zzuzpb/kicad-freakduino/hardware/freakduino-bom.numbers/preview-web.jpg

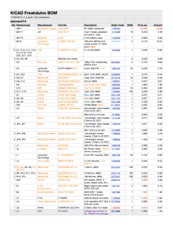
hardware/freakduino-bom.numbers/preview-web.jpg
