zzuzpb/kicad-freakduino/hardware/freakduino-bom.xls

Sheet: element14 - BOM
KiCAD Freakduino BOM
17/08/2013 v1.2 post-r132 corrections
element14
Qty | Reference(s) | Manufacturer | Part No. | Description | Order Code | MOQ | Price ea. | Amount
1 | ANT1 | Amphenol Connex | 132136RP | RP-SMA Connector | 1789593 (http://nz.element14.com/amphenol-connex/dp/1789593) | 1 | 23.660 | 23.66
1 | BATT1 | JST | S2B-XH-A | 2-pin mated, polarized connector, male | 1516289 (http://nz.element14.com/jst/dp/1516289) | 10 | 0.240 | 2.40
1 | BATT2 | Keystone | 2462 | 2-AA battery case | 1702630 (http://nz.element14.com/keystone/dp/1702630) | 1 | 2.660 | 2.66
1 | BLN1 | Johanson Technology | 2450BL14B100E | 100 ohm diff/50 ohm single ended, 2.4 GHz, balun 0805 | 1885503 | 5 | 2.110 | 10.55
10 | C1, C10, C11, C13, C14, C16, C18, C20, C21, C23 | TDK | C1608Y5V1H104Z | 0.1uF/50V,0603 | 1844266 (http://nz.element14.com/tdk/c16085v1h104z/capacitor-ceramic-0-1uf-50v5v-80/dp/1844266) | 1 | 0.030 | 0.30
0 | C2, R3, R9 |  | DNI (Do Not Insert) |  |  | 0 | 0.000 | 0.00
1 | C3 | Nichicon | UWX1C101MCL1GB | 100uF/16V, electrolytic, SMD 6.3mm | 8823065 (http://nz.element14.com/nichicon/dp/8823065) | 5 | 0.120 | 0.60
1 | C4 | Johanson Technology | 251R14S0R4AV4T | 0.4pf, 0603 RF, Hi Q | 1885354 (http://nz.element14.com/johanson-technology/251r14s0r4av4t/capacitor-hi-q-0603-250v-0-4pf/dp/1885354) | 25 | 0.228 | 5.70
2 | C5, C22 | TDK | C2012X5R0J226M/1.25 | 22uF, 6.3V, 0805, MLCC | 2309030 (http://nz.element14.com/tdk/c2012x5r0j226m-1-25/capacitor-22uf-6-3v-x5r-20-0805/dp/2309030) | 1 | 0.214 | 0.43
2 | C6, C7 | Multicomp | MC000291 | 5.6pf, 50V, 0402,RF | 2310316 (http://livepage.apple.com/) | 10 | 0.030 | 0.30
2 | C8, C12 | Multicomp | MC0603B103M250CT | 0.01uF, 0603 | 1709947 (http://nz.element14.com/multicomp/dp/1709947) | 1 | 0.007 | 0.01
1 | C9 | Nichicon | F920G226MPA | 22uf, 6.3V, Tant, 0805 | 1892302 (http://nz.element14.com/nichicon/dp/1892302) | 1 | 1.800 | 1.80
1 | C15 | AVX | 06036D106MAT2A | 10uF, 6.3V, 0603 | 1833804 (http://nz.element14.com/avx/dp/1833804) | 10 | 0.300 | 3.00
2 | C17, C19 | Multicomp | MC0603N120J101CT | 12pF, 50V, 0603 | 1759054 (http://nz.element14.com/multicomp/dp/1759054) | 100 | 0.029 | 2.90
1 | D1 | Vishay | VLMB1300-GS08 | Blue LED, 0603 | 2251459 (http://nz.element14.com/vishay/dp/2251459) | 1 | 0.207 | 0.21
2 | D2, D6 | Vishay | VLMO1300-GS08 | Red LED, 0603 | 2251473 (http://nz.element14.com/vishay/vlmo1300-gs08/led-0603-red/dp/2251473) | 1 | 0.207 | 0.41
2 | D3, D4 | Vishay | VLMTG1300-GS08 | Green LED, 0603 | 2251490 (http://nz.element14.com/vishay/dp/2251490) | 1 | 0.160 | 0.32
1 | FB1 | Fair-Rite | 2508051027Y0 | Ferrite Bead, 0805 | 2112874 (http://nz.element14.com/fair-rite/dp/2112874) | 1 | 0.022 | 0.02
1 | H3 | Molex | 10897061 (see below) | 3x2 straight male header, 2.54mm (0.100”) | 1508365 (http://nz.element14.com/molex/10897061/board-board-connector-header-6way/dp/1508365) | 1 | 0.902 | 0.90
 |  |  | -----> | 30x2 and cut to size | 1918095 (http://nz.element14.com/fci/dp/1918095) | 1 | 2.630 | 2.63
1 | JP1 | Molex | 22-28-5030 (see below) | 1x3 straight male header, 2.54mm (0.100”) | 1513726 (http://nz.element14.com/molex/22-28-5030/header-3way/dp/1513726) | 1 | 0.077 | 0.08
2 | JP2, JP7 | Molex | 22-28-4022 (see below) | 1x2 straight male header, 2.54mm (0.100”) | 1704910 (http://nz.element14.com/molex/22-28-4022/board-board-connector-header-2way/dp/1704910) | 1 | 0.201 | 0.40
 |  |  | -----> | 30x1 and cut to size | 1819800 (http://nz.element14.com/te-connectivity-amp/dp/1819800) | 1 | 4.060 | 4.06
2 | JP4, JP6 | Global Connector | BG095-08-A-N-D | 1x8 straight female header, 2.54mm (0.100”) | 1799005 (http://nz.element14.com/global-connector-technology/dp/1799005) | 1 | 1.890 | 3.78
2 | JP3, JP5 | Global Connector | BG095-06-A-N-D | 1x6 straight female header, 2.54mm (0.100”) | 1799003 (http://nz.element14.com/global-connector-technology/dp/1799003) | 1 | 1.420 | 2.84
1 | J1 | Multicomp | MC32598 | USB Mini-AB connector | 1696539 (http://nz.element14.com/multicomp/mc32598/mini-usb-type-ab-receptacle-smt/dp/1696539) | 1 | 2.280 | 2.28
1 | J2 | Lumberg | NEB 21 R | DC Power Jack, 1.95mm center conductor | 1217037 (http://nz.element14.com/lumberg/dp/1217037) | 1 | 2.260 | 2.26
1 | L1 | Johanson Technology | L-14C3N3SV4T | 3.3nH RF inductor, 0603 | 1865790 (http://nz.element14.com/johanson-technology/dp/1865790) | 50 | 0.132 | 6.60
1 | L2 | Taiyo Yuden | NR4018T4R7M | 4.7uH inductor, 1.2A, 4x4mm | 1284636 (http://nz.element14.com/taiyo-yuden/dp/1284636) | 1 | 0.550 | 0.55
7 | R1, R2, R4, R5, R7, R8, R12 | Multicomp | MCMR06X102 JTL | 1 Kohm, 0603 | 2073354 (http://nz.element14.com/multicomp/mcmr06x102-jtl/resistor-anti-sulfur-1k-0603-5/dp/2073354) | 100 | 0.005 | 0.50
4 | R6, R10, R11, R13 | Multicomp | MCSR06X103 JTL | 10 Kohms, 0603 | 2074170 (http://nz.element14.com/multicomp/mcsr06x103-jtl/resistor-anti-sulfur-10k-0603-5/dp/2074170) | 100 | 0.003 | 0.30
2 | R14, R15 | Multicomp | MCMR06X104 JTL | 100 Kohms, 0603 | 2073357 (http://nz.element14.com/multicomp/mcmr06x104-jtl/resistor-anti-sulfur-100k-0603/dp/2073357) | 100 | 0.003 | 0.30
1 | SW1 | Omron | A6TN-2104 | DIP switch, SPST, 2 poles, raised slide, thru | 2066443 (http://nz.element14.com/omron-electronic-components/a6tn-2104/dip-switch-2-spst-raised-slide/dp/2066443) | 1 | 2.660 | 2.66
1 | S1 | C & K Components | OS102011MA1QN1 | Right angle slide switch, SPDT, ON-ON | 1201431 (http://nz.element14.com/c-k-components/os102011ma1qn1/switch-spdt-0-1a-12v-pcb-r-a/dp/1201431) | 5 | 1.820 | 9.10
1 | S2 | Wurth Elektronik | 430471031826 | SMD SPST Tactile Switch/Pushbutton | 1867986 (http://nz.element14.com/wurth-elektronik/430471031826/switch-260gf-washable-blk-smd-3/dp/1867986) | 1 | 1.360 | 1.36
1 | U1 | FTDI | FT232RL | USB-to-Serial converter | 1146032 (http://nz.element14.com/ftdi/ft232rl/ic-usb-to-uart-smd-28ssop/dp/1146032) | 1 | 11.830 | 11.83
1 | U2 | Texas Instruments | LM3940IMP-3.3 | 3.3V regulator SOT-223-3 (IGO pin order) | 9779280 (http://nz.element14.com/texas-instruments/dp/9779280) | 1 | 2.280 | 2.28
1 | U3 | Atmel | AT86RF231-ZU QFN | 2.4GHz, 802.15.4 radio. | 1748493 (http://nz.element14.com/atmel/at86rf231-zu/transceiver-zigbee-802-15-4-4-32qfn/dp/1748493) | 1 | 8.970 | 8.97
1 | U4 | NXP | GTL2003 | Voltage level shifter, 8-bit, TSSOP-20 package | 2212068 (http://nz.element14.com/nxp/gtl2003pw/ic-gtl-lo-volt-translator-20tssop/dp/2212068) | 1 | 1.260 | 1.26
1 | U5 | Texas Instruments | TPS61222DCKT | 5V boost converter | 1755643 (http://livepage.apple.com/) | 1 | 2.930 | 2.93
1 | U6 | Atmel | ATMEGA328-AU | AVR Microcontroller QFP32 | 1972086 (http://nz.element14.com/atmel/atmega328-au/mcu-8bit-avr-32k-flash-32tqfp/dp/1972086) | 1 | 4.450 | 4.45
1 | VR1 | ST Micro | L78M05CDT-TR | 5.0V regulator D-PAK 500mA | 1261392 (http://nz.element14.com/stmicroelectronics/l78m05cdt-tr/ic-linear-voltage-regulator-5v/dp/1261392) | 1 | 0.890 | 0.89
1 | Y1 | Aker | C3E-16.000-12-1010-X | 16MHz crystal, 10ppm, 12pf | 1640978 (http://nz.element14.com/aker/c3e-16-000-12-1010-x/crystal-2-5x3mm-cer-16-000mhz/dp/1640978) | 1 | 6.210 | 6.21
 |  |  |  |  |  |  | Total | 134.70
COLOUR KEY
 | BLACK | As originally specified for Freakduino v2.1a.
 | ORANGE | Alternative part with same footprint as original. Additional orange text shows difference in part parameters.
 | PURPLE | Alternative part with different footprint to original.
 | RED | Part not available and no alternative so far found. Red in price column indicates price unreasonably high.

Sheet: digikey - BOM
KiCAD Freakduino BOM
DigiKey
Qty | Reference(s) | Manufacturer | Part No. | Description | DigiKey SKU | MOQ | USD ea. | Amount
1 | ANT1 | ChangHong | SMA-02-113-TGG | RP-SMA Connector |  |  | 0.00
1 | BATT1 | JST | JST-XH2P | 2-pin mated, polarized connector, male
1 | BATT2 | COMF | BH321-1P | 2-AA battery case
1 | BLN1 | Murata | LDB-182G4510C-110 | 100 ohm diff/50 ohm single ended, 2.4GHz, balun
10 | C1,C10,C11,C13,C14,C16,C18,C20,C21,C23 | Various |  | 0.1uF/50V,0603
0 | C2,R3,R9 |  | DNI
1 | C3 | Various |  | 100uF/16V
1 | C4 | Johanson Technology | 251R14S0R4 | 0.4pf,0603 RF capacitor
2 | C5,C22 | Various |  | 22uF, 6.3V,0805, MLCC
2 | C6,C7 | Taiyo Yuden | UMK105C-G5R6DW-F | 5.6pf,50V,0402,RF
2 | C8,C12 | Various |  | 0.01uF, 0603
2 | C9,C15 | Various |  | 100uF, 35V, thru
2 | C17,C19 | Various |  | 12pF, 50V, 0603
1 | D1 | Various |  | Blue LED, 0603
2 | D2,D6 | Various |  | Red LED, 0603
2 | D3,D4 | Various |  | Green LED, 0603
1 | D5 | Vishay | BAT43 | Schottky Diode, thru
1 | FB1 | Various |  | Ferrite Bead, 0805
1 | H3 | Various | H3X2 | 3x2 straight male header, 2.54mm (0.100”)
1 | JP1 | Various | JP3/THRU_VERT | 1x3 straight male header, 2.54mm (0.100”)
2 | JP2,JP7 | Various | 1X2 | 1x2 straight male header, 2.54mm (0.100”)
2 | JP4,JP6 | Various |  | 1x8 straight male header, 2.54mm (0.100”)
2 | JP3,JP5 | Various |  | 1x6 straight male header, 2.54mm (0.100”)
1 | J1 | 4UCON | 9558 | USB Mini-AB connector
1 | J2 | 4UCON | 5537 | DC Power Jack, 2.0mm center conductor
1 | L1 | Johanson Technology | L-14C3N3SV4T | 3.3nH RF inductor
1 | L2 | Various |  | 47uH inductor, 200mA, thru
5 | R1,R2,R7,R8,R12 | Various |  | 220 ohms, 0603
4 | R6,R10,R11,R13 |  |  | 10 Kohms, 0603
2 | R14,R15 | Various |  | 100 Kohms, 0603
2 | R4,R5 | Various |  | 1 Kohm, 0603
1 | SW1 | Various |  | 2-input DIP switch, thru
1 | S1 | Various |  | Right angle slide switch
1 | S2 | Various |  | SMD SPST Tactile Switch/Pushbutton
1 | U1 | FTDI | FT232RL | USB-to-Serial converter
1 | U2 | Microchip | TC1264-3.3 | 3.3V regulator
1 | U3 | Atmel | AT86RF231 | 2.4GHz, 802.15.4 radio
1 | U4 | Fairchild | FXMA108 | Voltage level converter, DQFN-20 package | FXMA108BQXFSCT-ND (http://www.digikey.com/product-detail/en/FXMA108BQX/FXMA108BQXFSCT-ND/2287325) | 1 | 1.52
1 | U5 | Holtek | HT7750A | 5V boost converter | NOT AVAILABLE
1 | U6 | Atmel | ATMEGA328-QFP32 | AVR Microcontroller
1 | VR1 | NJRC | NJM2845-5.0 | 5.0V regulator
1 | Y1 | NDK | NX3225SA,15ppm | 16MHz crystal, 15ppm
