zzuzpb/kicad-freakduino/hardware/parts-layout/parts-layout_v1.2.png

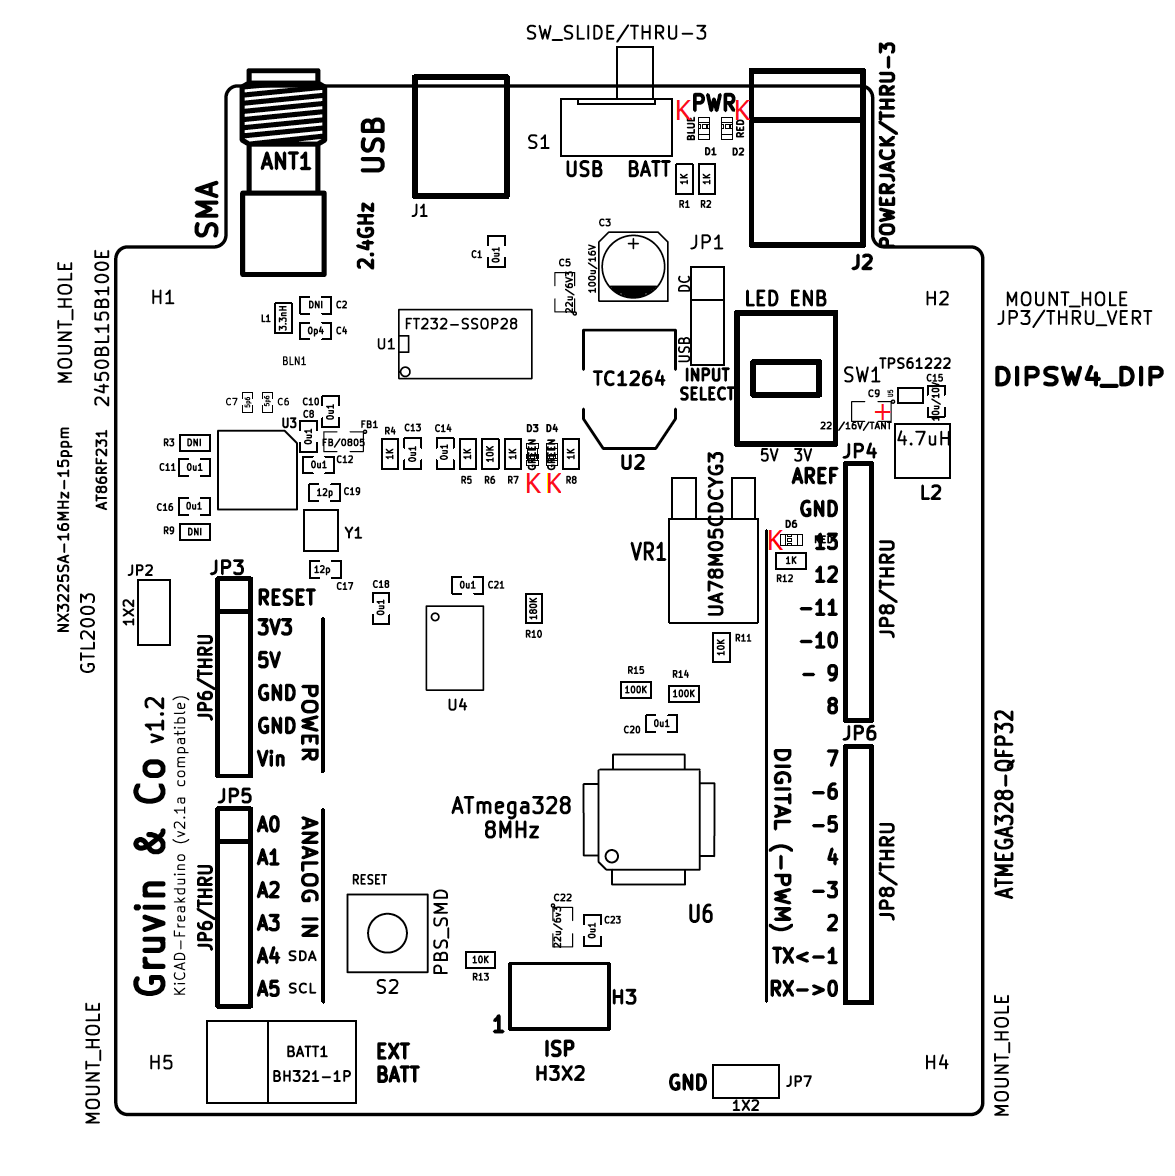
hardware/parts-layout/parts-layout_v1.2.png
