zzuzpb/kicad-freakduino/hardware/radio-only-bom.numbers/preview-web.jpg

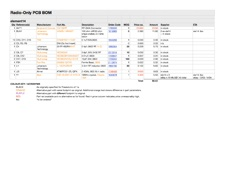
hardware/radio-only-bom.numbers/preview-web.jpg
