zzuzpb/kicad-freakduino/hardware/parts-layout/parts-layout_v1.2.pdf

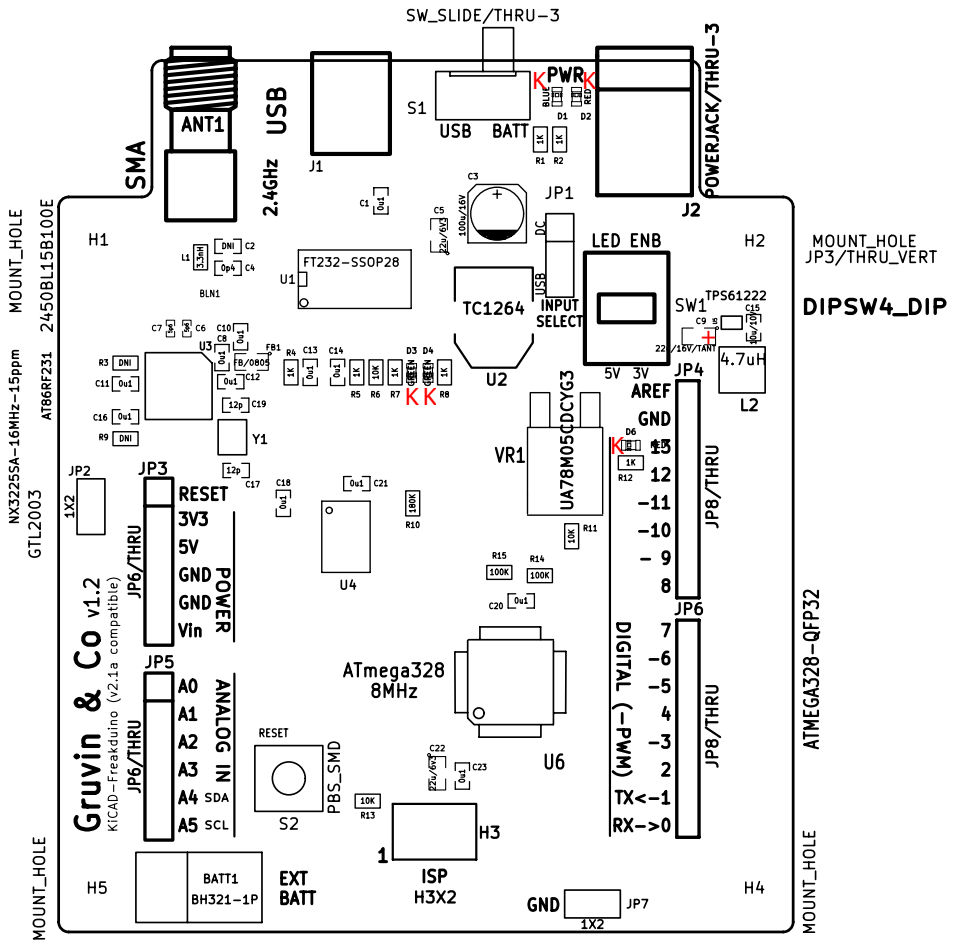
[picture p4: page 1]
