zzuzpb/kicad-freakduino/hardware/freakduino-alt.sch

## KiCad design hardware/freakduino-alt.sch (2014-03-27)

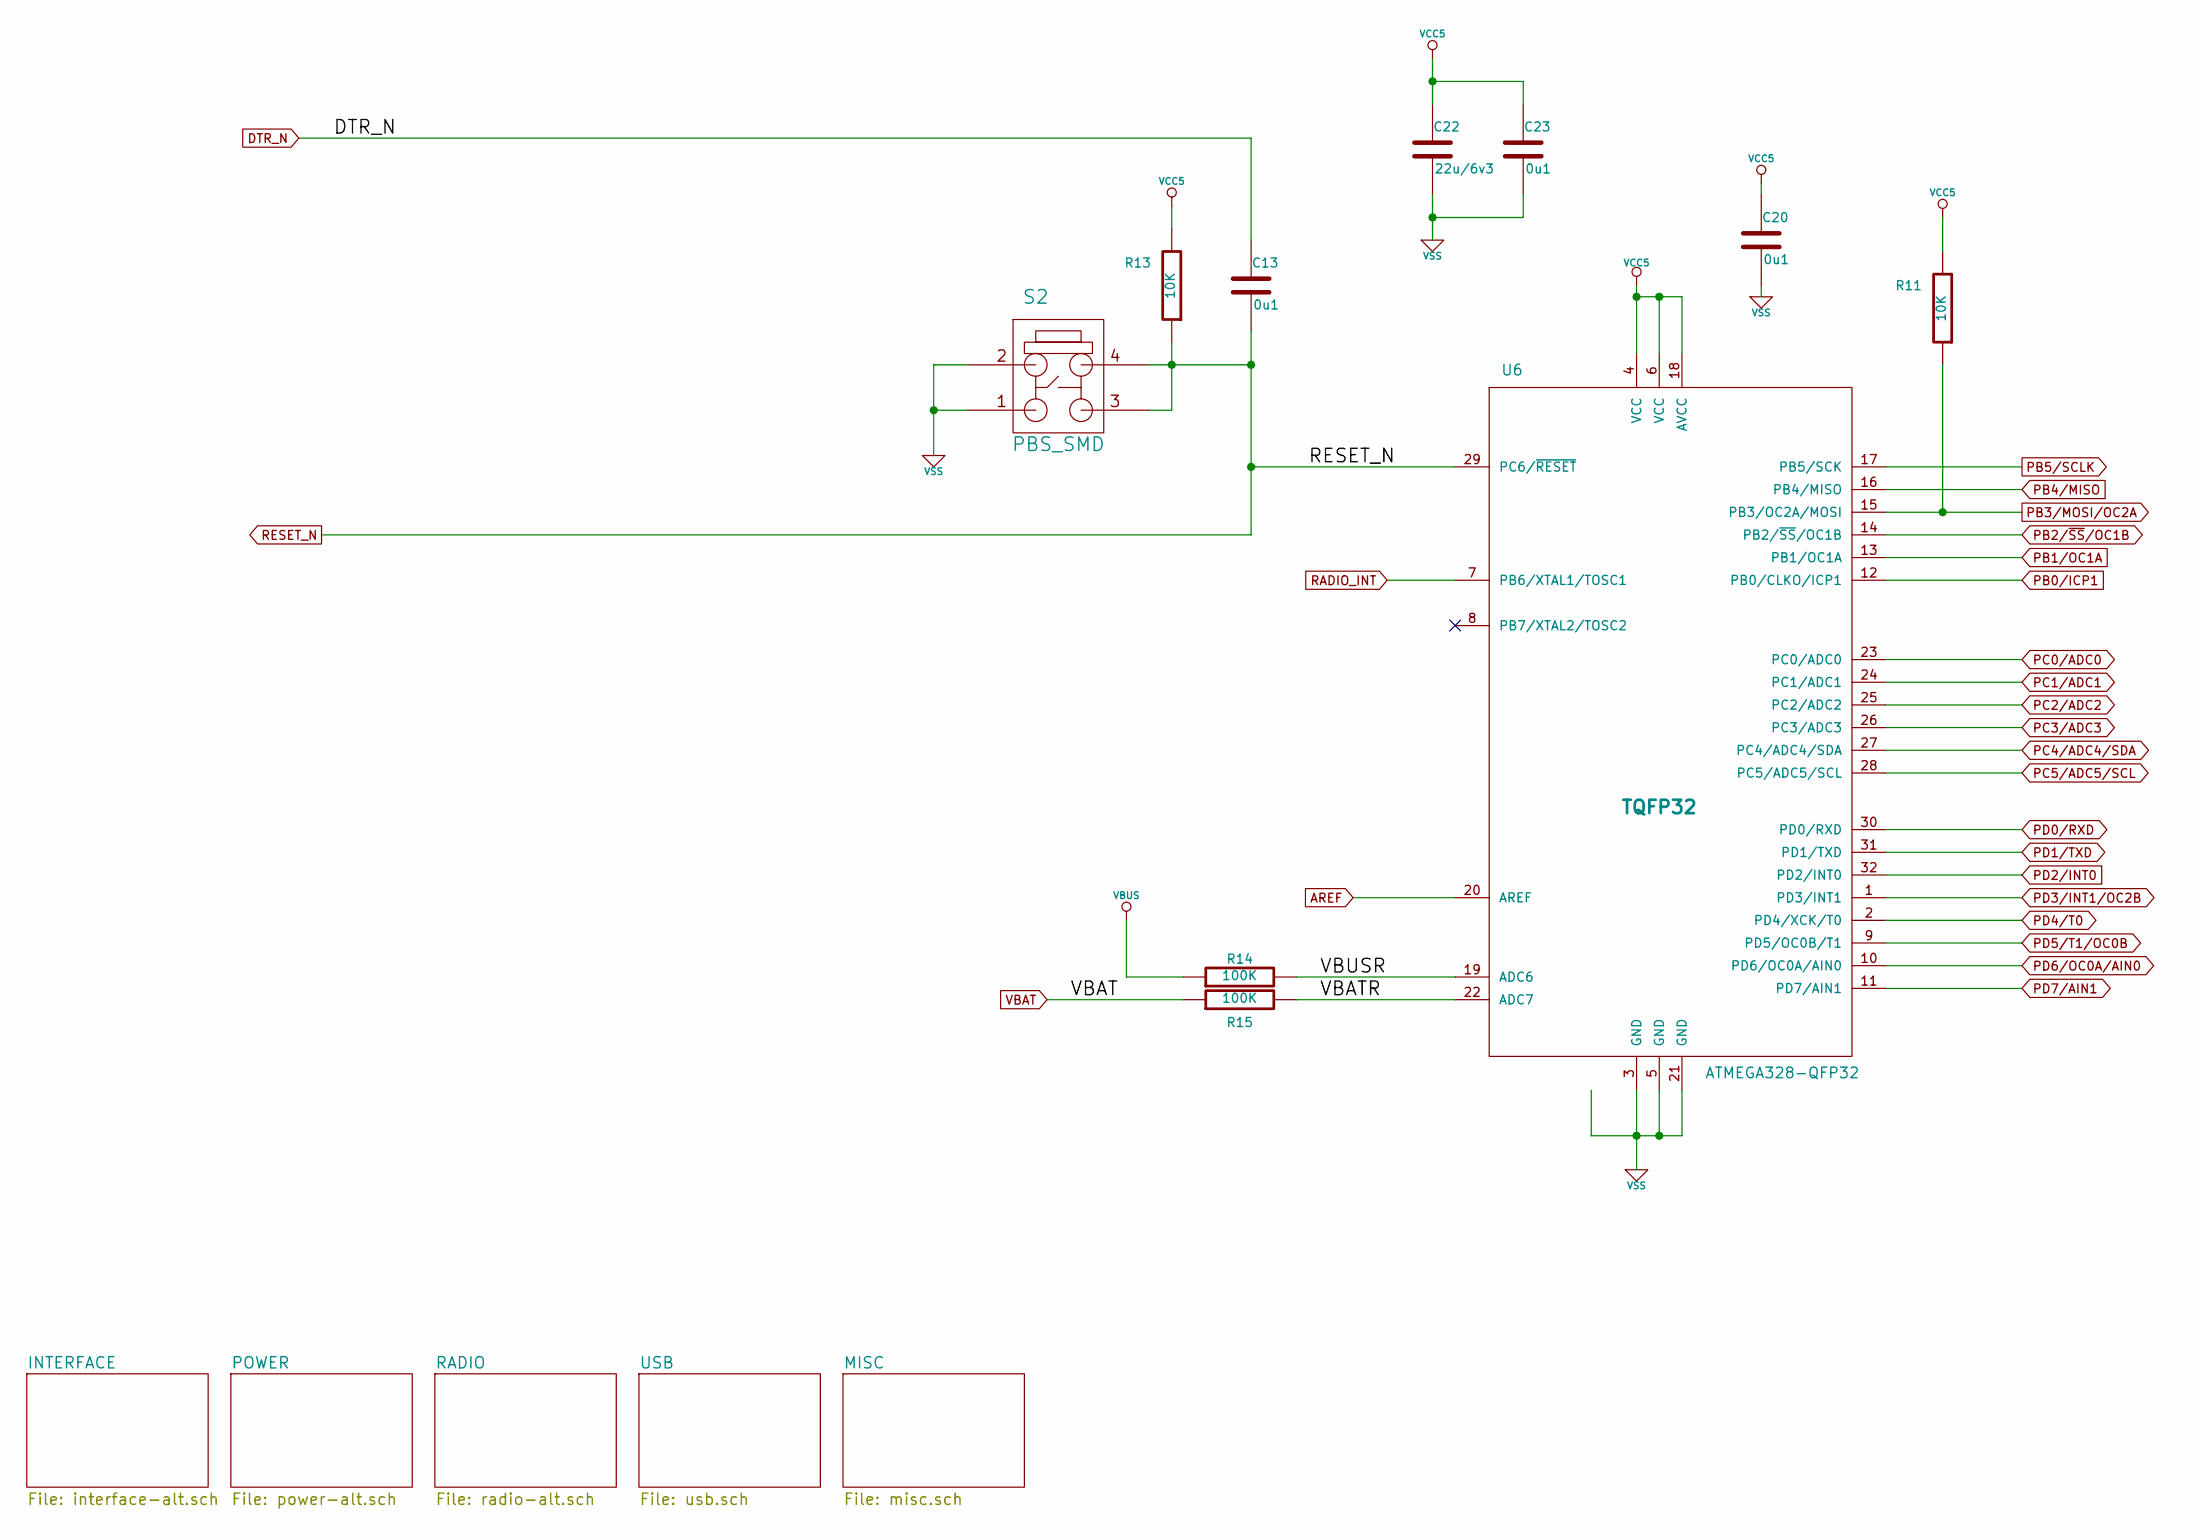
[picture p5: schematic freakduino-alt.sch]

Parts:
C13, C20, C23: 0u1
C22: 22u/6v3
R11, R13: 10K
R14, R15: 100K
S2: PBS_SMD
U6: ATMEGA328-QFP32; TQFP32

Connections:
AREF: U6.20 (AREF)
DTR_N: C13.1
PB0/ICP1: U6.12 (PB0/CLKO/ICP1)
PB1/OC1A: U6.13 (PB1/OC1A)
PB2/~SS~/OC1B: U6.14 (PB2/~SS~/OC1B)
PB3/MOSI/OC2A: R11.1, U6.15 (PB3/OC2A/MOSI)
PB4/MISO: U6.16 (PB4/MISO)
PB5/SCLK: U6.17 (PB5/SCK)
PC0/ADC0: U6.23 (PC0/ADC0)
PC1/ADC1: U6.24 (PC1/ADC1)
PC2/ADC2: U6.25 (PC2/ADC2)
PC3/ADC3: U6.26 (PC3/ADC3)
PC4/ADC4/SDA: U6.27 (PC4/ADC4/SDA)
PC5/ADC5/SCL: U6.28 (PC5/ADC5/SCL)
PD0/RXD: U6.30 (PD0/RXD)
PD1/TXD: U6.31 (PD1/TXD)
PD2/INT0: U6.32 (PD2/INT0)
PD3/INT1/OC2B: U6.1 (PD3/INT1)
PD4/T0: U6.2 (PD4/XCK/T0)
PD5/T1/OC0B: U6.9 (PD5/OC0B/T1)
PD6/OC0A/AIN0: U6.10 (PD6/OC0A/AIN0)
PD7/AIN1: U6.11 (PD7/AIN1)
RADIO_INT: U6.7 (PB6/XTAL1/TOSC1)
RESET_N: C13.2, R13.1, S2.3, S2.4, U6.29 (PC6/~RESET)
VBAT: R15.1
VBATR: R15.2, U6.22 (ADC7)
VBUS: R14.1
VBUSR: R14.2, U6.19 (ADC6)
VCC5: C20.1, C22.1, C23.1, R11.2, R13.2, U6.4 (VCC), U6.6 (VCC), U6.18 (AVCC)
VSS: C20.2, C22.2, C23.2, S2.1, S2.2, U6.3 (GND), U6.5 (GND), U6.21 (GND)
