zzuzpb/kicad-freakduino/hardware/interface.sch

## KiCad design hardware/interface.sch (2014-03-03)

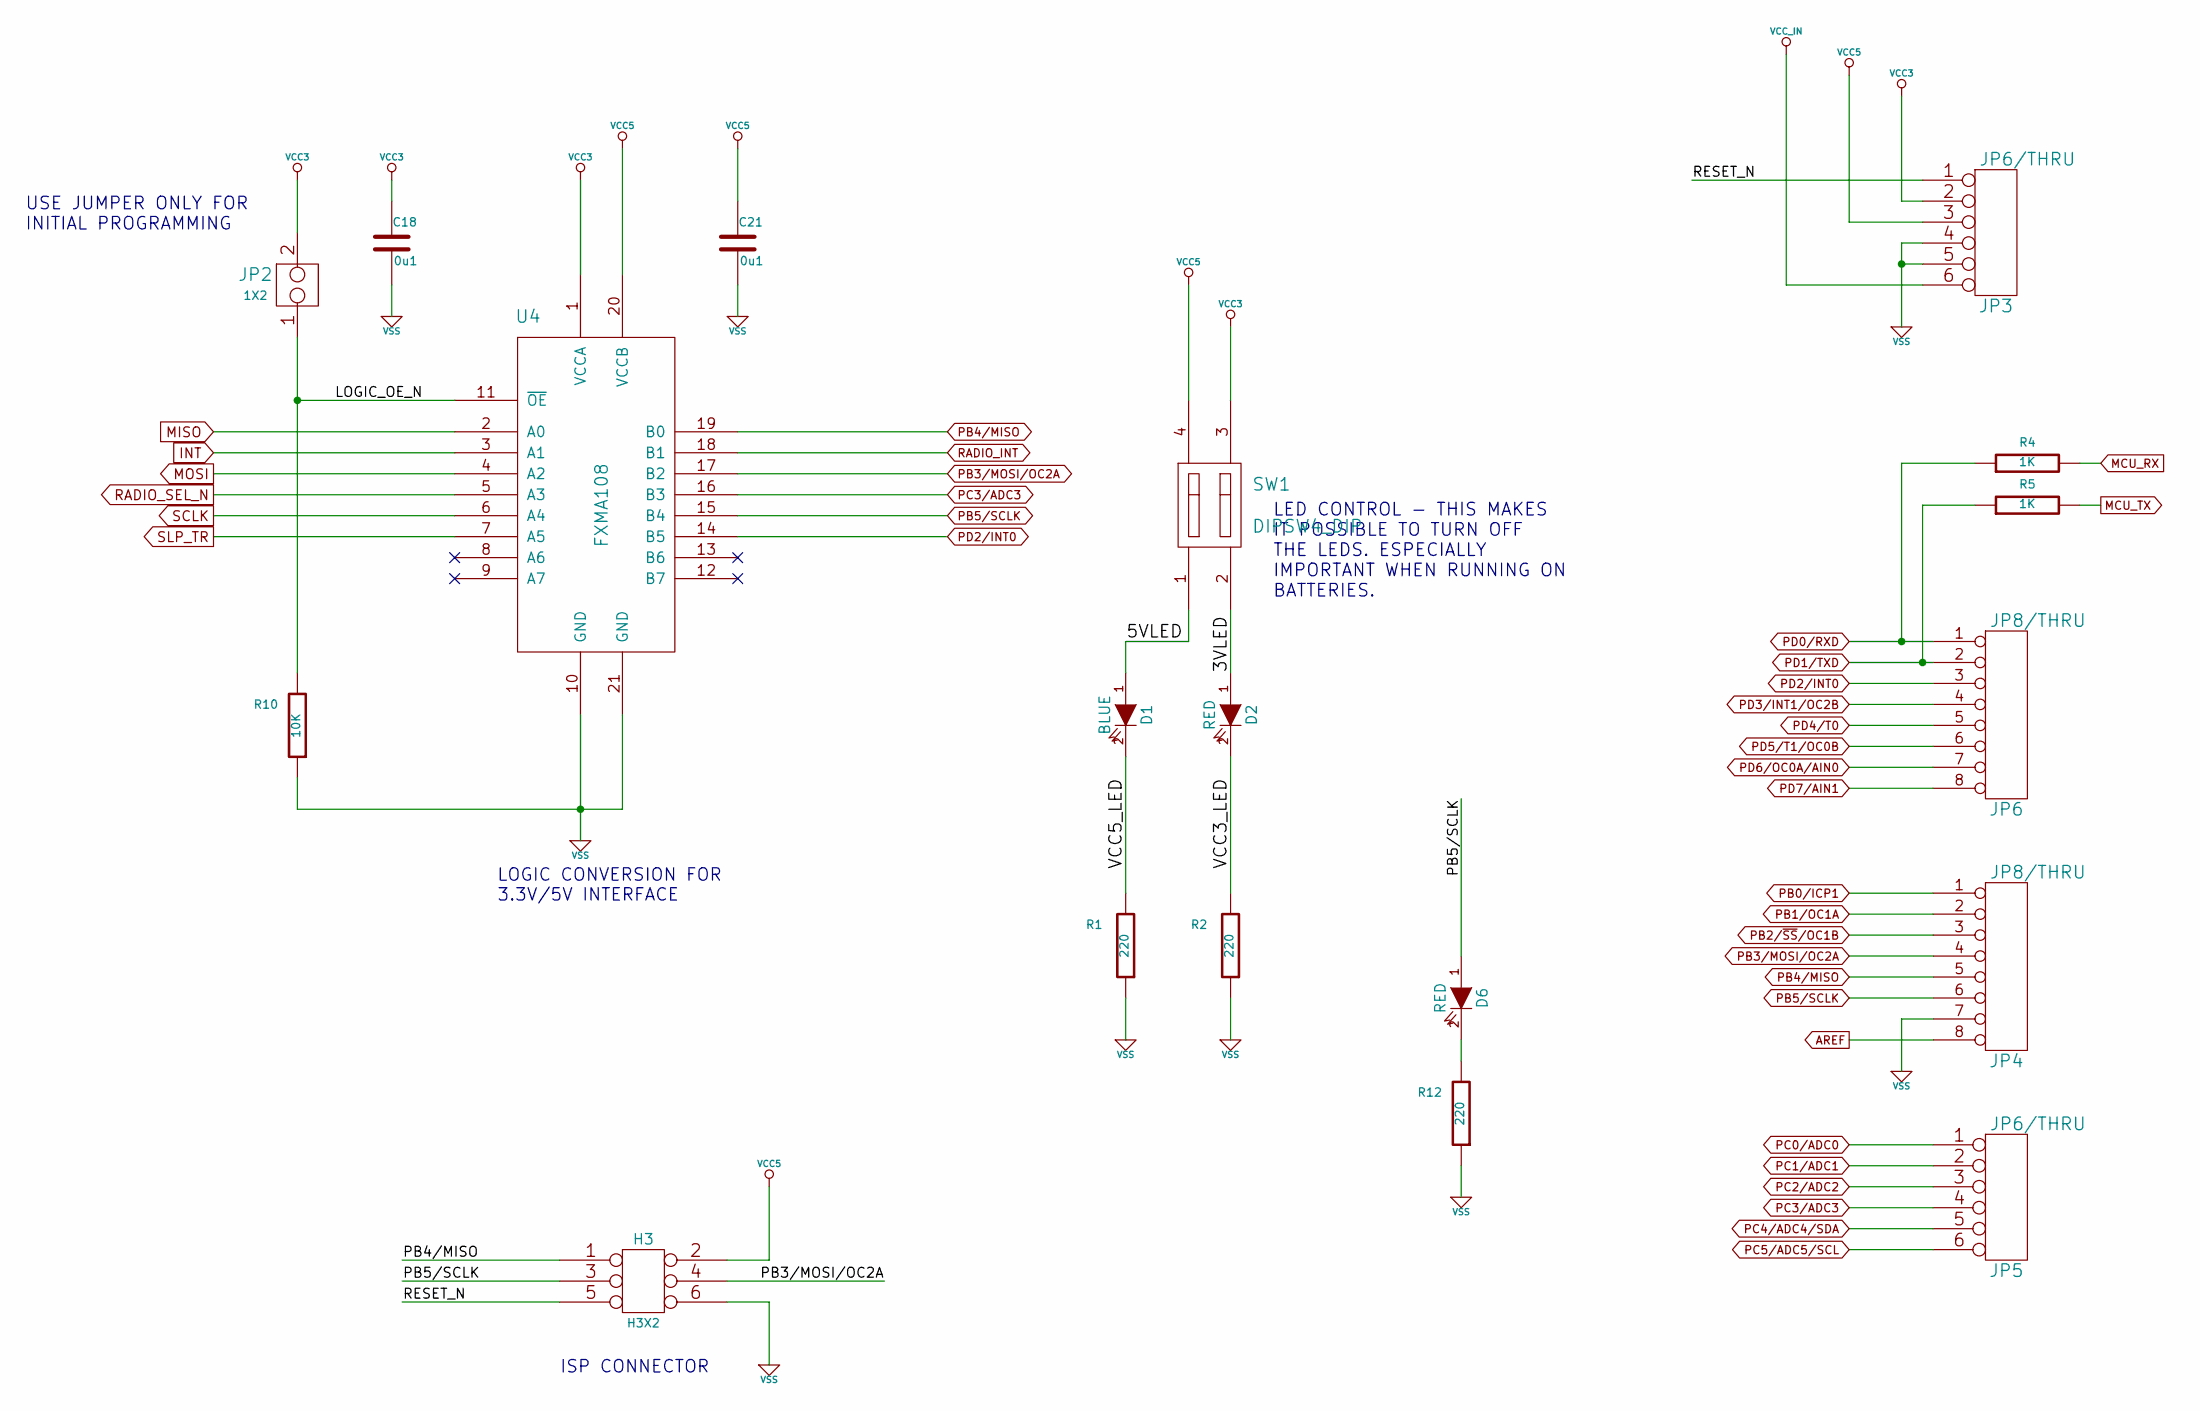
[picture p7: schematic interface.sch]

Parts:
C18, C21: 0u1
D1: BLUE
D2, D6: RED
H3: H3X2
JP2: 1X2
JP3, JP5: JP6/THRU
JP4, JP6: JP8/THRU
R1, R2, R12: 220
R4, R5: 1K
R10: 10K
SW1: DIPSW4_DIP
U4: FXMA108

Connections:
3VLED: D2.1 (A), SW1.2
5VLED: D1.1 (A), SW1.1
AREF: JP4.8
INT: U4.3 (A1)
LOGIC_OE_N: JP2.1, R10.2, U4.11 (~OE)
MCU_RX: R4.2
MCU_TX: R5.2
MISO: U4.2 (A0)
MOSI: U4.4 (A2)
unnamed: D6.2 (K), R12.2
PB0/ICP1: JP4.1
PB1/OC1A: JP4.2
PB2/~SS~/OC1B: JP4.3
PB3/MOSI/OC2A: H3.4, JP4.4, U4.17 (B2)
PB4/MISO: H3.1, JP4.5, U4.19 (B0)
PB5/SCLK: D6.1 (A), H3.3, JP4.6, U4.15 (B4)
PC0/ADC0: JP5.1
PC1/ADC1: JP5.2
PC2/ADC2: JP5.3
PC3/ADC3: JP5.4, U4.16 (B3)
PC4/ADC4/SDA: JP5.5
PC5/ADC5/SCL: JP5.6
PD0/RXD: JP6.1, R4.1
PD1/TXD: JP6.2, R5.1
PD2/INT0: JP6.3, U4.14 (B5)
PD3/INT1/OC2B: JP6.4
PD4/T0: JP6.5
PD5/T1/OC0B: JP6.6
PD6/OC0A/AIN0: JP6.7
PD7/AIN1: JP6.8
RADIO_INT: U4.18 (B1)
RADIO_SEL_N: U4.5 (A3)
RESET_N: H3.5, JP3.1
SCLK: U4.6 (A4)
SLP_TR: U4.7 (A5)
VCC3: C18.1, JP2.2, JP3.2, SW1.3, U4.1 (VCCA)
VCC3_LED: D2.2 (K), R2.2
VCC5: C21.1, H3.2, JP3.3, SW1.4, U4.20 (VCCB)
VCC5_LED: D1.2 (K), R1.2
VCC_IN: JP3.6
VSS: C18.2, C21.2, H3.6, JP3.4, JP3.5, JP4.7, R1.1, R2.1, R10.1, R12.1, U4.10 (GND), U4.21 (GND)

Notes on the sheet:
LOGIC CONVERSION FOR 3.3V/5V INTERFACE
USE JUMPER ONLY FOR INITIAL PROGRAMMING
LED CONTROL - THIS MAKES IT POSSIBLE TO TURN OFF THE LEDS. ESPECIALLY IMPORTANT WHEN RUNNING ON BATTERIES.
ISP CONNECTOR
