zzuzpb/kicad-freakduino/hardware/misc.sch

## KiCad design hardware/misc.sch (2014-03-27)

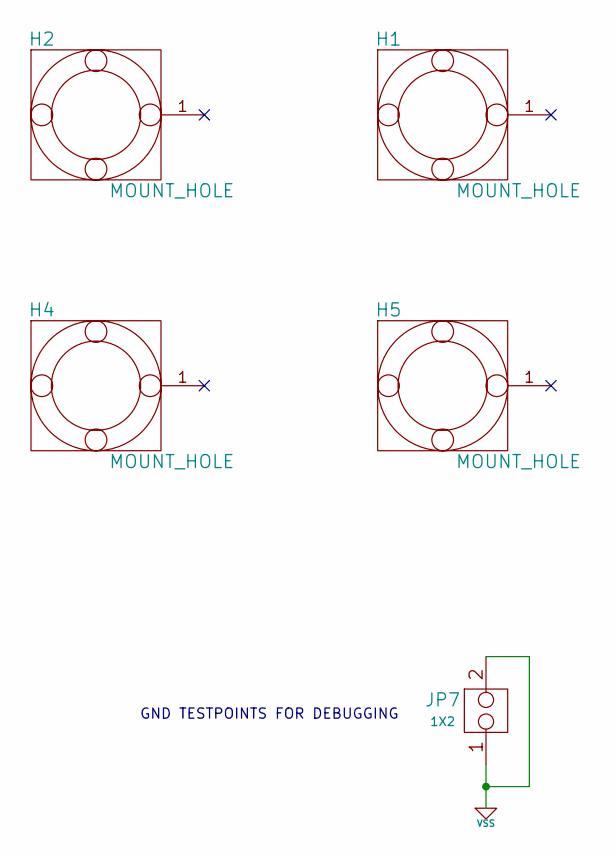
[picture p8: schematic misc.sch]

Parts:
H1, H2, H4, H5: MOUNT_HOLE
JP7: 1X2

Connections:
VSS: JP7.1, JP7.2

Notes on the sheet:
GND TESTPOINTS FOR DEBUGGING
