zzuzpb/kicad-freakduino/hardware/power-alt.sch

## KiCad design hardware/power-alt.sch (2014-03-03)

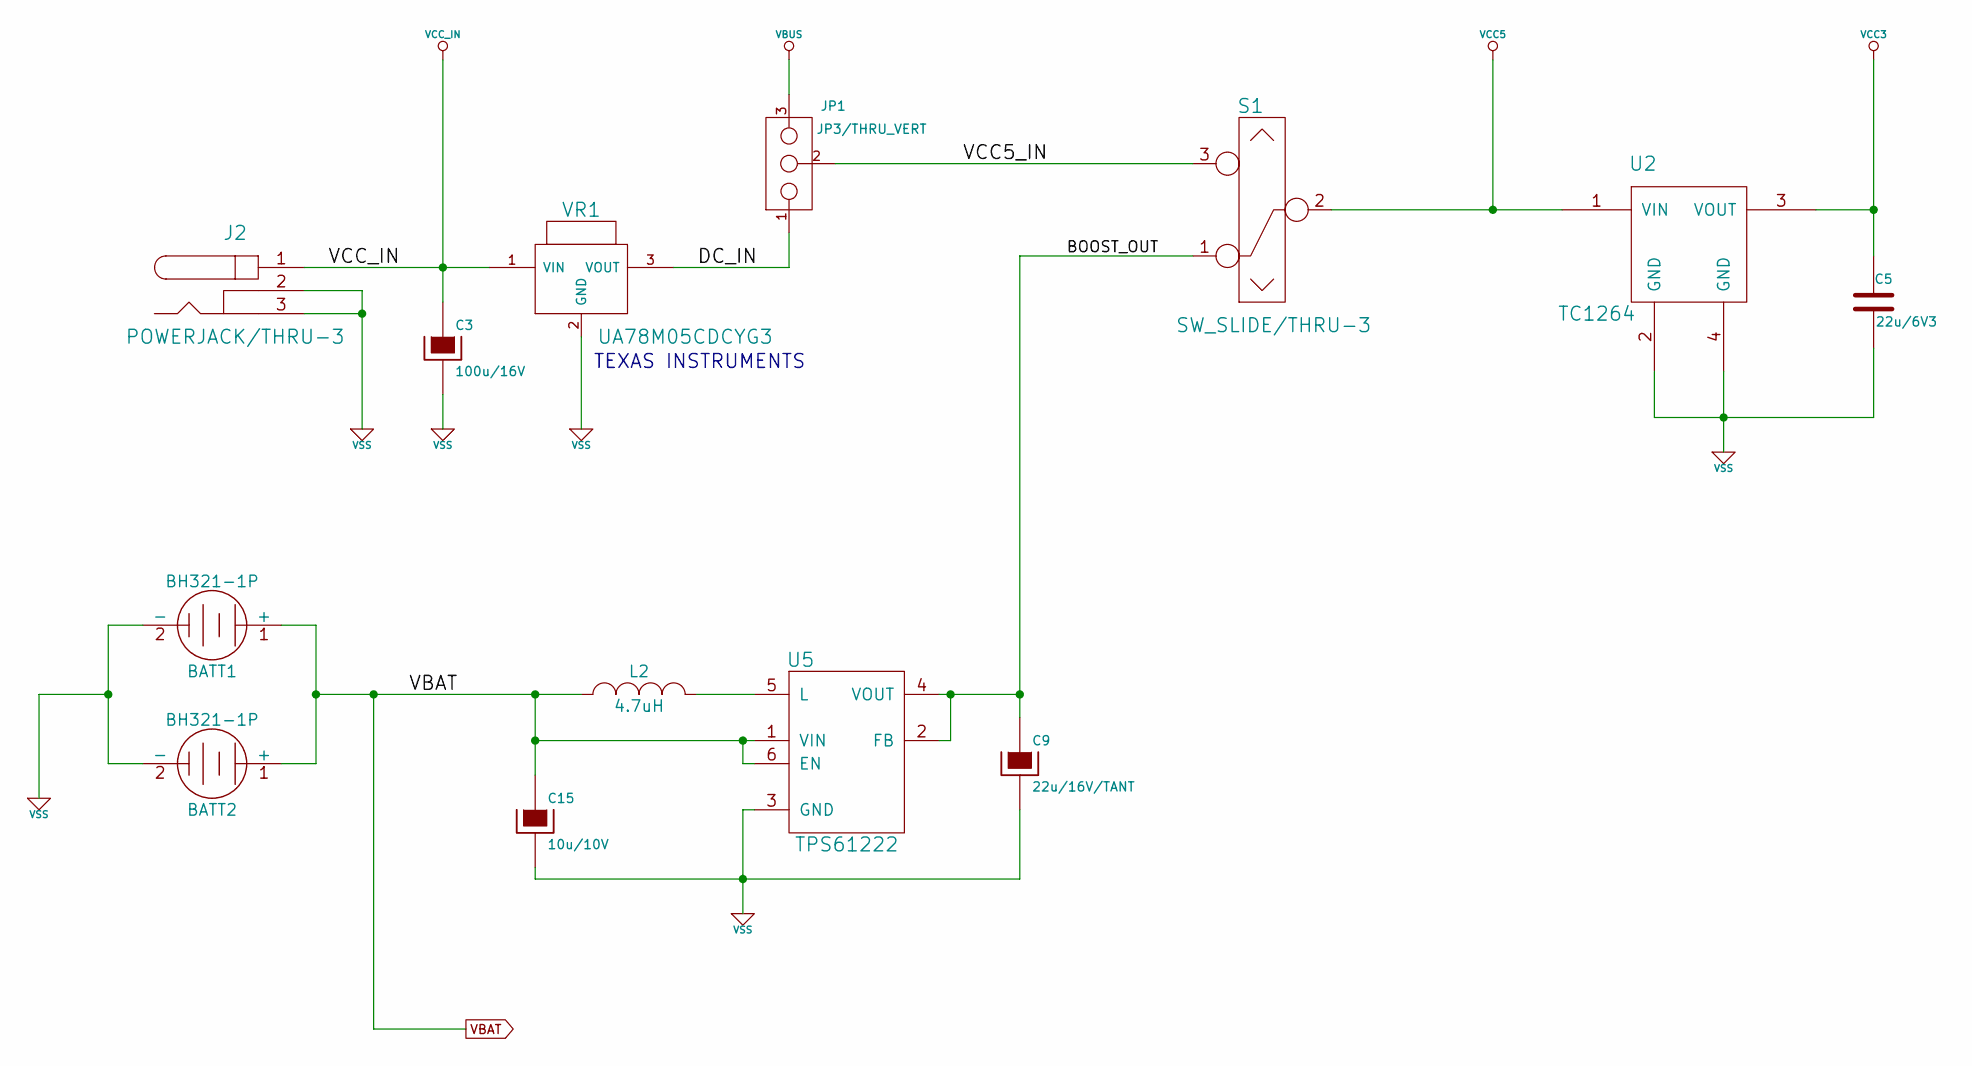
[picture p9: schematic power-alt.sch]

Parts:
BATT1, BATT2: BH321-1P
C3: 100u/16V
C5: 22u/6V3
C9: 22u/16V/TANT
C15: 10u/10V
J2: POWERJACK/THRU-3
JP1: JP3/THRU_VERT
L2: 4.7uH
S1: SW_SLIDE/THRU-3
U2: TC1264
U5: TPS61222
VR1: UA78M05CDCYG3

Connections:
BOOST_OUT: C9.1, S1.1, U5.2 (FB), U5.4 (VOUT)
DC_IN: JP1.1, VR1.3 (VOUT)
unnamed: L2.2, U5.5 (L)
VBAT: BATT1.1 (+), BATT2.1 (+), C15.1, L2.1, U5.1 (VIN), U5.6 (EN)
VBUS: JP1.3
VCC3: C5.1, U2.3 (VOUT)
VCC5: S1.2, U2.1 (VIN)
VCC5_IN: JP1.2, S1.3
VCC_IN: C3.1, J2.1, VR1.1 (VIN)
VSS: BATT1.2 (-), BATT2.2 (-), C3.2, C5.2, C9.2, C15.2, J2.2, J2.3, U2.2 (GND), U2.4 (GND), U5.3 (GND), VR1.2 (GND)

Notes on the sheet:
TEXAS INSTRUMENTS
