zzuzpb/kicad-freakduino/hardware/power.sch

## KiCad design hardware/power.sch (2014-03-03)

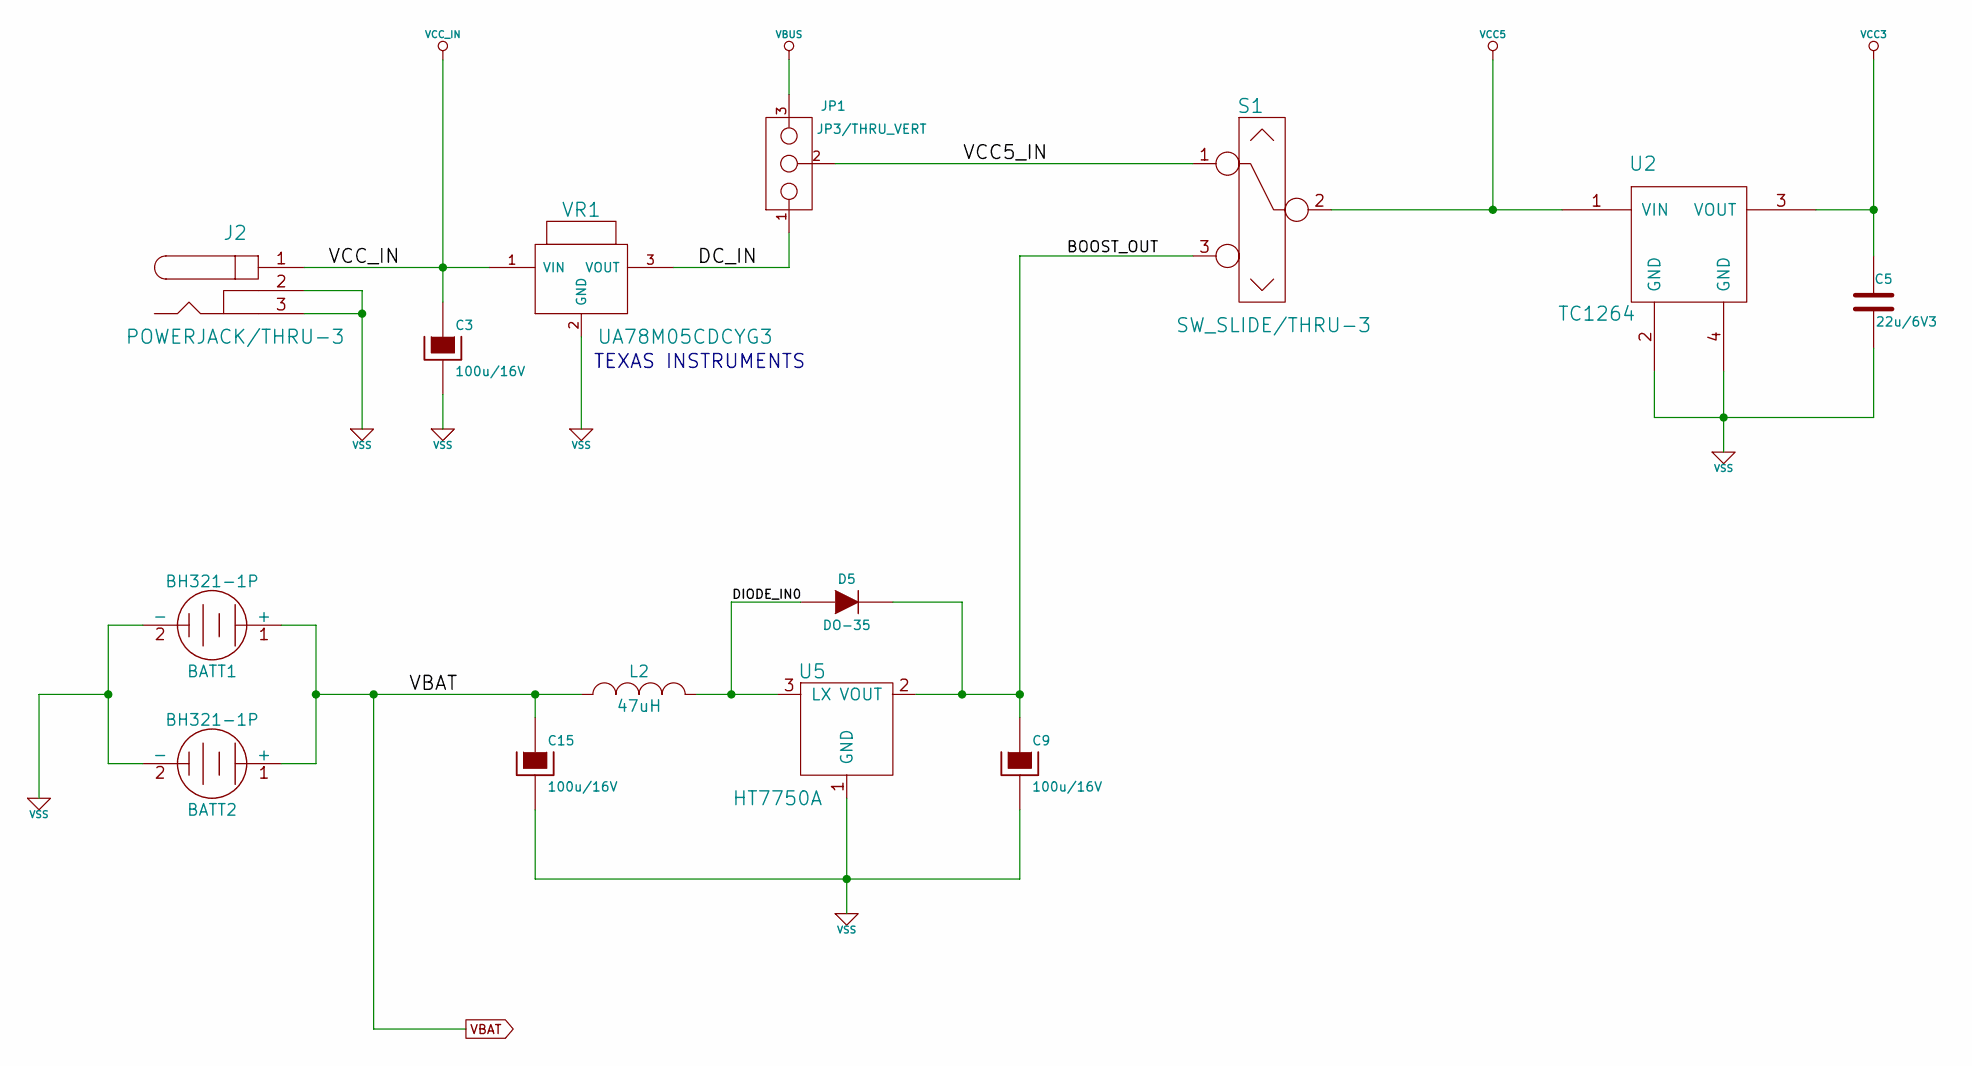
[picture p10: schematic power.sch]

Parts:
BATT1, BATT2: BH321-1P
C3, C9, C15: 100u/16V
C5: 22u/6V3
D5: DO-35; Part No BAT43
J2: POWERJACK/THRU-3
JP1: JP3/THRU_VERT
L2: 47uH
S1: SW_SLIDE/THRU-3
U2: TC1264
U5: HT7750A
VR1: UA78M05CDCYG3

Connections:
BOOST_OUT: C9.1, D5.2 (K), S1.3, U5.2 (VOUT)
DC_IN: JP1.1, VR1.3 (VOUT)
DIODE_IN0: D5.1 (A), L2.2, U5.3 (LX)
VBAT: BATT1.1 (+), BATT2.1 (+), C15.1, L2.1
VBUS: JP1.3
VCC3: C5.1, U2.3 (VOUT)
VCC5: S1.2, U2.1 (VIN)
VCC5_IN: JP1.2, S1.1
VCC_IN: C3.1, J2.1, VR1.1 (VIN)
VSS: BATT1.2 (-), BATT2.2 (-), C3.2, C5.2, C9.2, C15.2, J2.2, J2.3, U2.2 (GND), U2.4 (GND), U5.1 (GND), VR1.2 (GND)

Notes on the sheet:
TEXAS INSTRUMENTS
