zzuzpb/kicad-freakduino/hardware/radio-alt.sch

## KiCad design hardware/radio-alt.sch (2014-03-03)

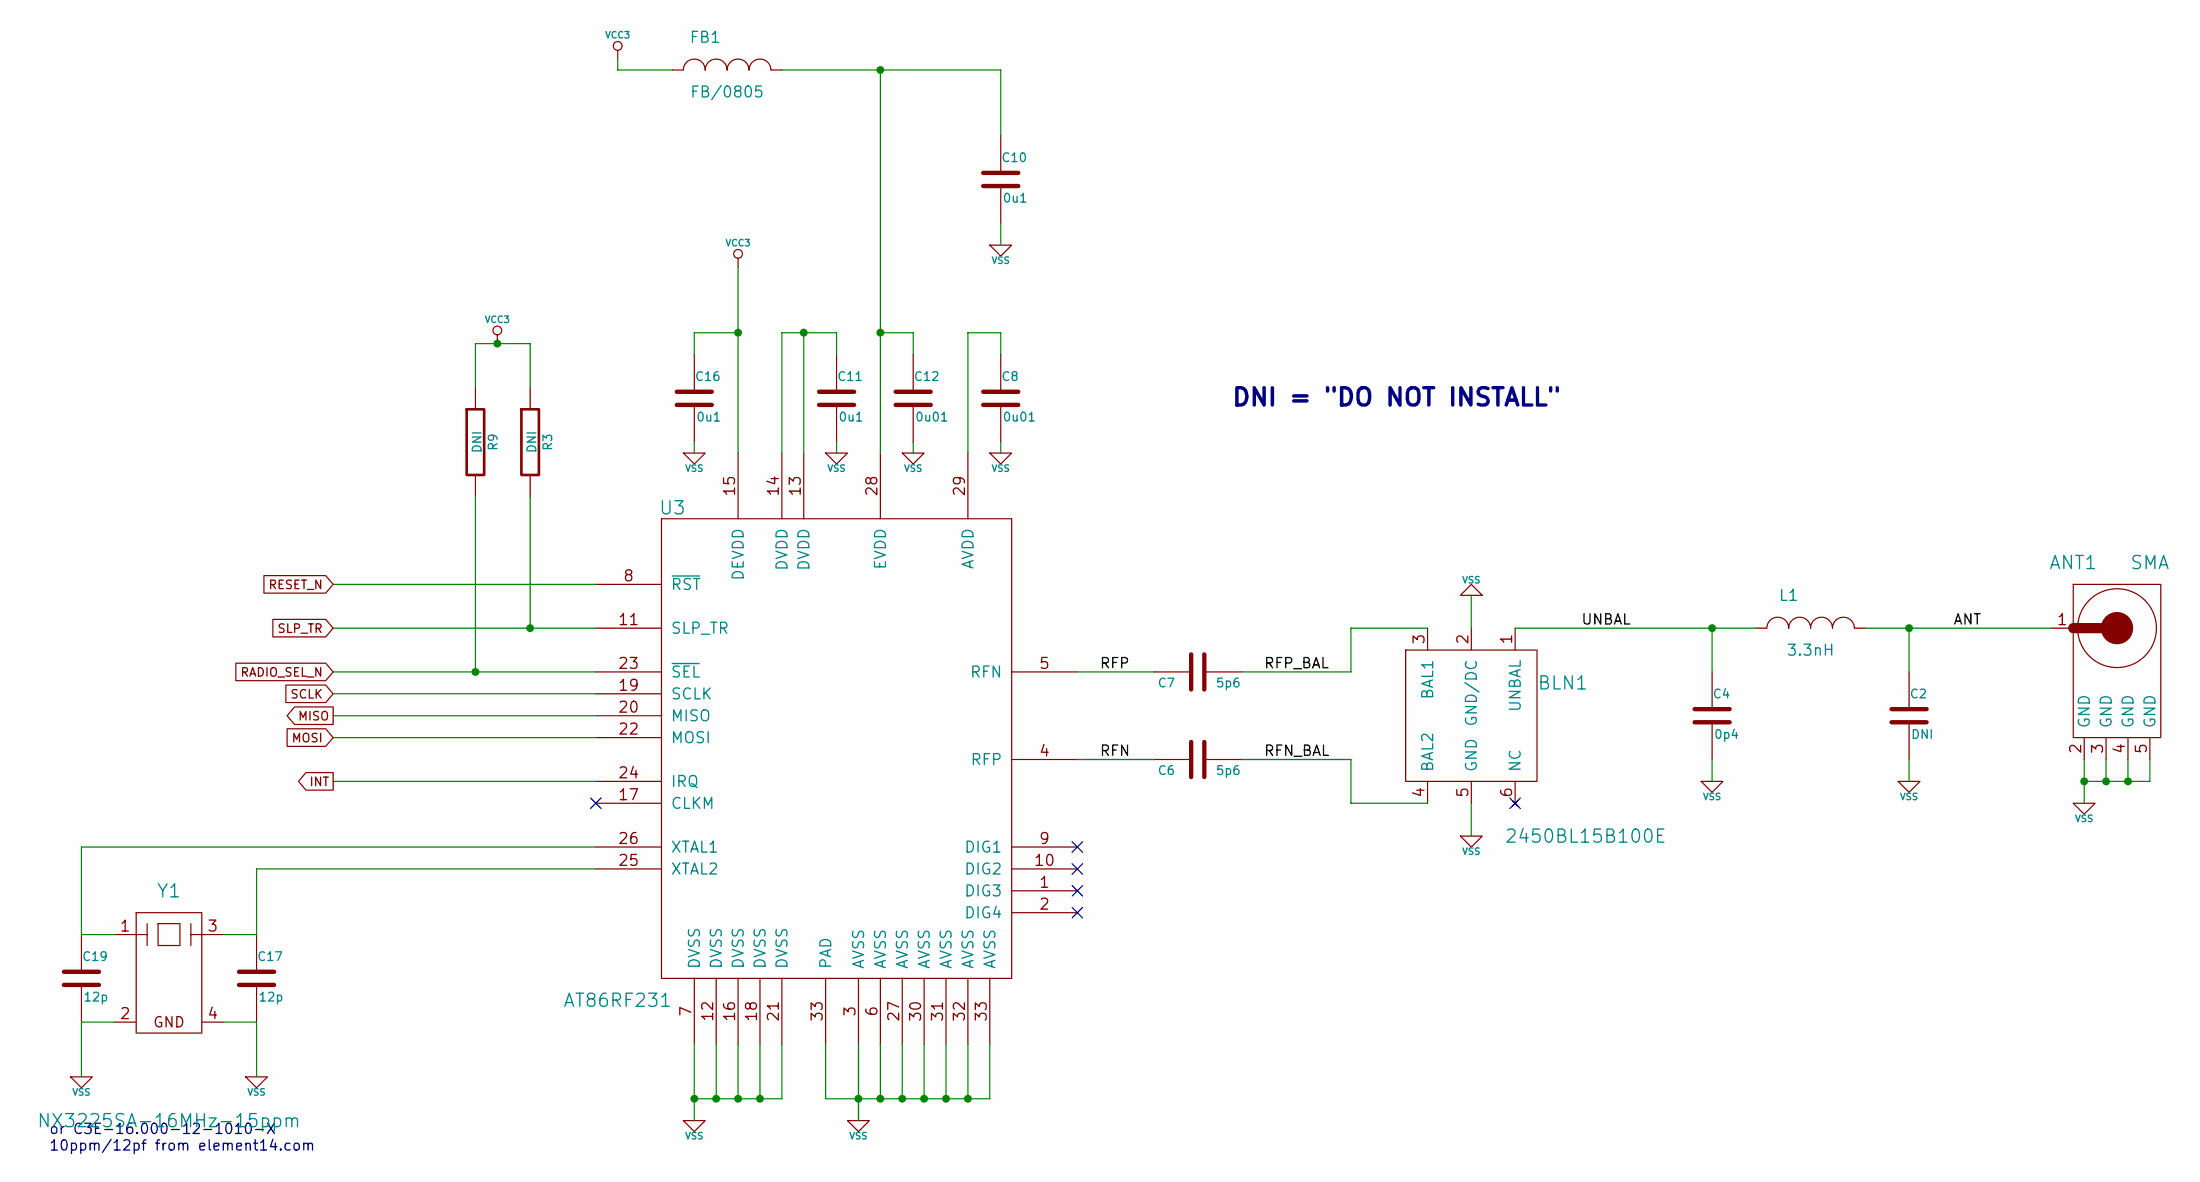
[picture p11: schematic radio-alt.sch]

Parts:
ANT1: SMA
BLN1: 2450BL15B100E
C2: DNI
C4: 0p4
C6, C7: 5p6
C8, C12: 0u01
C10, C11, C16: 0u1
C17, C19: 12p
FB1: FB/0805
L1: 3.3nH
R3, R9: DNI
U3: AT86RF231
Y1: NX3225SA-16MHz-15ppm

Connections:
ANT: ANT1.1, C2.1, L1.2
INT: U3.24 (IRQ)
MISO: U3.20 (MISO)
MOSI: U3.22 (MOSI)
unnamed: C8.1, U3.29 (AVDD)
unnamed: C10.1, C12.1, FB1.2, U3.28 (EVDD)
unnamed: C11.1, U3.13 (DVDD), U3.14 (DVDD)
unnamed: C17.1, U3.25 (XTAL2), Y1.3 (X2)
unnamed: C19.1, U3.26 (XTAL1), Y1.1 (X1)
RADIO_SEL_N: R9.2, U3.23 (~SEL)
RESET_N: U3.8 (~RST)
RFN: C6.1, U3.4 (RFP)
RFN_BAL: BLN1.4 (BAL2), C6.2
RFP: C7.1, U3.5 (RFN)
RFP_BAL: BLN1.3 (BAL1), C7.2
SCLK: U3.19 (SCLK)
SLP_TR: R3.2, U3.11 (SLP_TR)
UNBAL: BLN1.1 (UNBAL), C4.1, L1.1
VCC3: C16.1, FB1.1, R3.1, R9.1, U3.15 (DEVDD)
VSS: ANT1.2 (GND), ANT1.3 (GND), ANT1.4 (GND), ANT1.5 (GND), BLN1.2 (GND/DC), BLN1.5 (GND), C2.2, C4.2, C8.2, C10.2, C11.2, C12.2, C16.2, C17.2, C19.2, U3.3 (AVSS), U3.6 (AVSS), U3.7 (DVSS), U3.12 (DVSS), U3.16 (DVSS), U3.18 (DVSS), U3.21 (DVSS), U3.27 (AVSS), U3.30 (AVSS), U3.31 (AVSS), U3.32 (AVSS), U3.33 (AVSS), Y1.2 (GND), Y1.4 (GND)

Notes on the sheet:
or C3E-16.000-12-1010-X 10ppm/12pf from element14.com
DNI = "DO NOT INSTALL"
