zzuzpb/kicad-freakduino/hardware/usb.sch

## KiCad design hardware/usb.sch (2014-03-27)

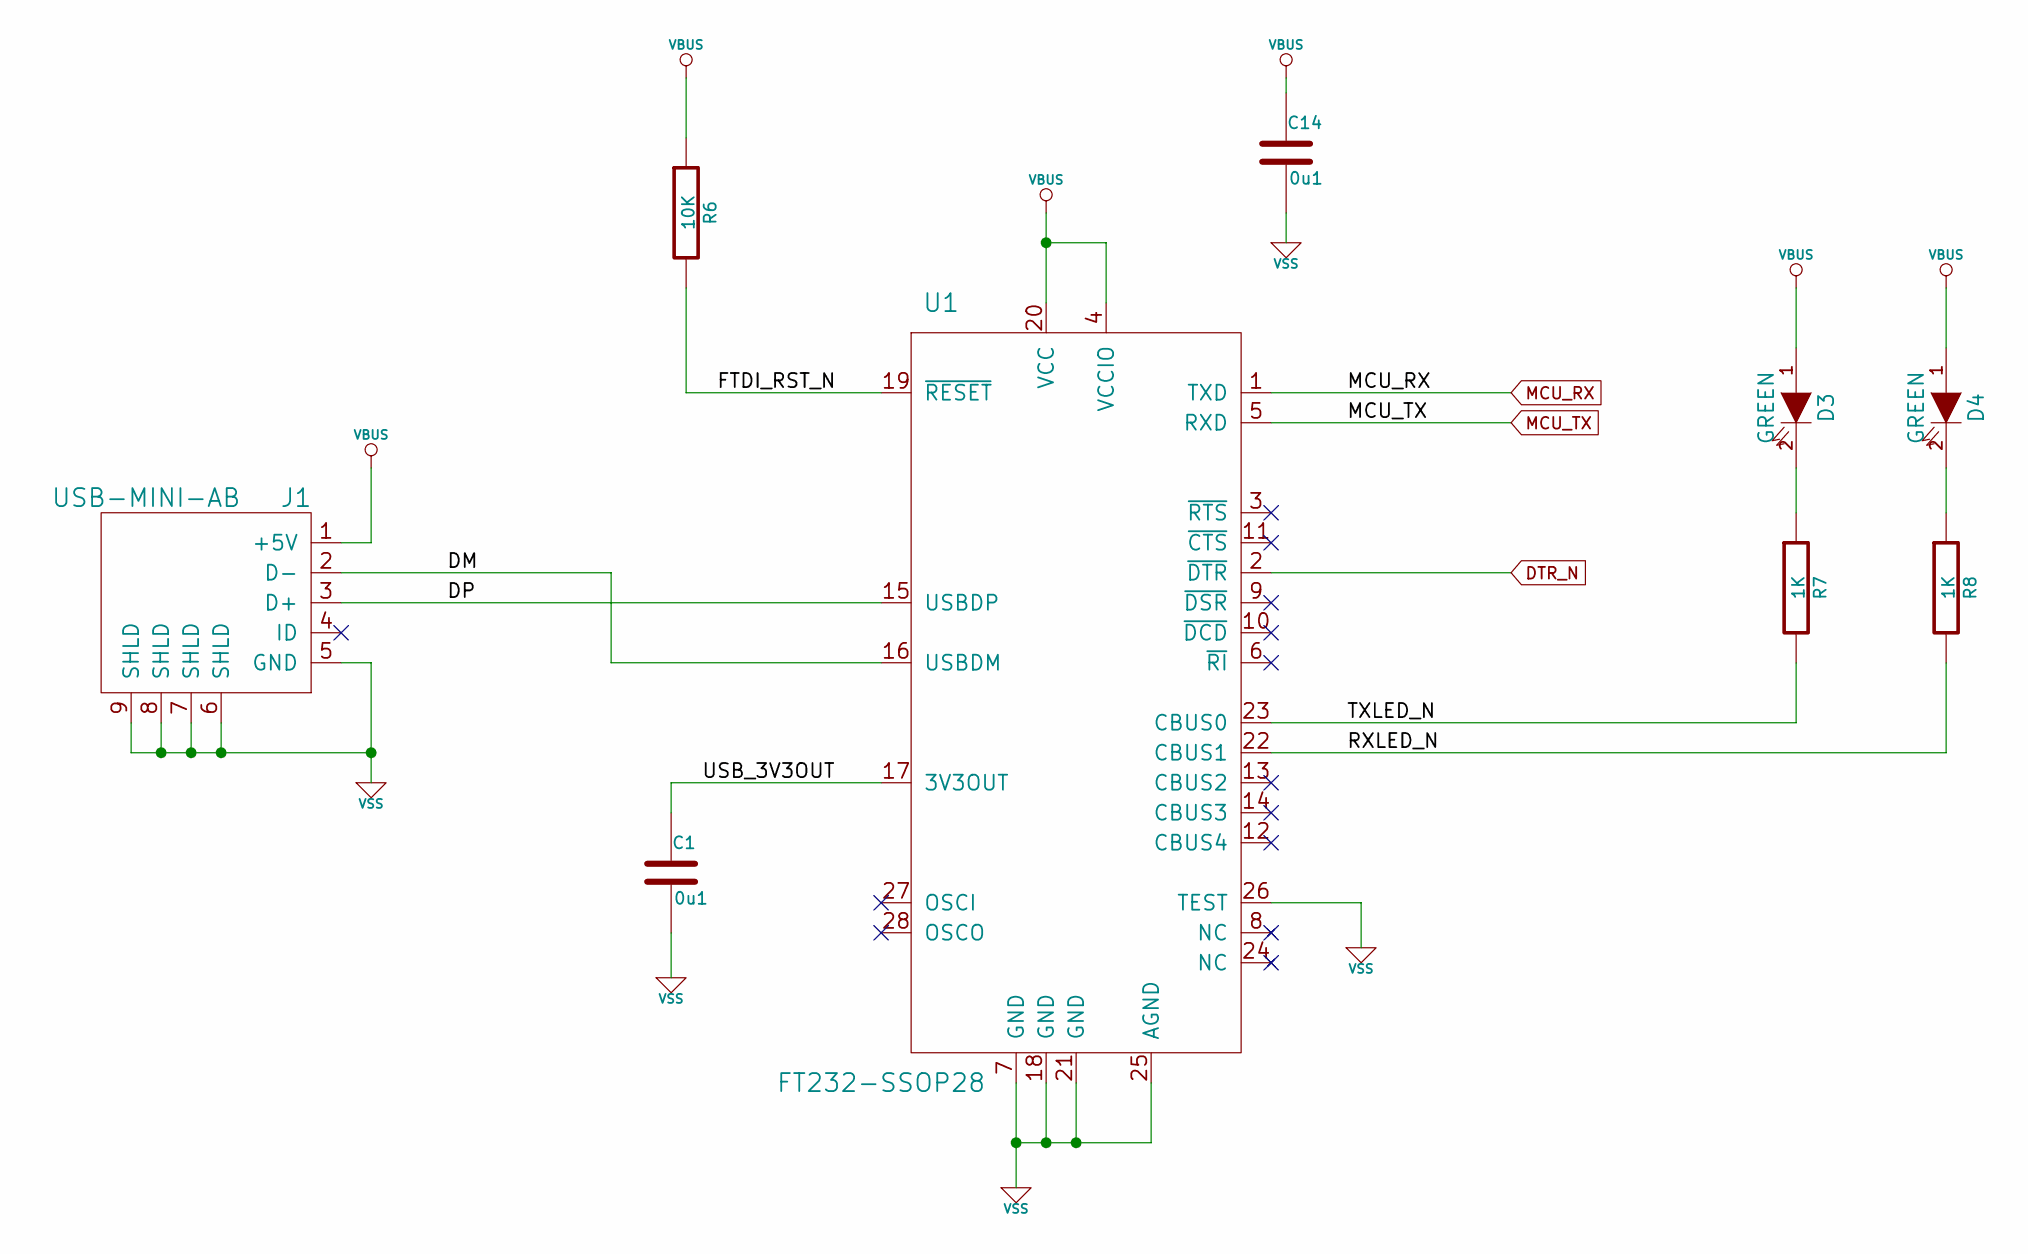
[picture p12: schematic usb.sch]

Parts:
C1, C14: 0u1
D3, D4: GREEN
J1: USB-MINI-AB
R6: 10K
R7, R8: 1K
U1: FT232-SSOP28

Connections:
DM: J1.2 (D-), U1.16 (USBDM)
DP: J1.3 (D+), U1.15 (USBDP)
DTR_N: U1.2 (~DTR)
FTDI_RST_N: R6.2, U1.19 (~RESET)
MCU_RX: U1.1 (TXD)
MCU_TX: U1.5 (RXD)
unnamed: D3.2 (K), R7.1
unnamed: D4.2 (K), R8.1
RXLED_N: R8.2, U1.22 (CBUS1)
TXLED_N: R7.2, U1.23 (CBUS0)
USB_3V3OUT: C1.1, U1.17 (3V3OUT)
VBUS: C14.1, D3.1 (A), D4.1 (A), J1.1 (+5V), R6.1, U1.4 (VCCIO), U1.20 (VCC)
VSS: C1.2, C14.2, J1.5 (GND), J1.6 (SHLD), J1.7 (SHLD), J1.8 (SHLD), J1.9 (SHLD), U1.7 (GND), U1.18 (GND), U1.21 (GND), U1.25 (AGND), U1.26 (TEST)
