zzuzpb/kicad-freakduino/(commit log)

2013-07-15 Initial commit.
    [freakduino.sch, interface.sch, misc.sch, peripherals.sch, power.sch, radio.sch, usb.sch]
2013-07-15 misc title updates, new PDF created
    [freakduino.sch, interface.sch, misc.sch, power.sch, radio.sch, usb.sch]
2013-07-16 Created first bill of materials file (BOM) for supplier element14 (Farnell).
    Quite a few parts have been substituted for eqivalents available from element14.
    Two parts are not available at all. One has a potential replacement, in a larger
    package. The BOM files (Apple Numbers and MS Excel versions) have a colour key
    to indicate what I changed, etc.
    I have emailed Akiba to ask where he sources the missing parts. He may even be
    able to give details of a decent electronics parts supplier in Japan, which
    would be a great bonus, I think -- though likely not in English.
    The BOM files also contain the beginnings of a DigiKey sheet, mostly blank at
    this time.
    [freakduino-bom.xls]
2013-07-16 Corrected some colour coding in BOM files.
    Still can't get Sueversion ignore to work when using 'svn add'. It works for
    'svn status', though. So there's clearly a bug. I've never had this problem
    before. Strange.
    [freakduino-bom.xls, interface.sch, misc.sch, power.sch, radio.sch, usb.sch]
2013-07-16 Started PCB layout.
    Board edges are done and most of the component modules are pre-placed.
    There's a few decisions to make about substitute parts and custom
    module drawing to be done accordingly.
    Minor change to BOM files.
    [freakduino-bom.xls, freakduino.brd, freakduino.sch, misc.sch]
2013-07-16 PCB: Some missing modules and 3d drawings added.
    [freakduino.brd, freakduino.sch]
2013-07-16 PCB: Module corrections
    [freakduino.brd]
2013-07-17 PCB: Alternative GTL2003(SOT360-1) replaces FXMA108(DQFN) part.
    Thus, now using interface-alt.sch, with interface.sch remaining as
    original version.
    [freakduino.brd, interface-alt.sch]
2013-07-17 PCB: package3d update for U4
    [freakduino.brd]
2013-07-17 SCH: minor corrections to interface-alt.sch
    [freakduino.sch, interface-alt.sch, misc.sch, power.sch, radio.sch, usb.sch]
2013-07-17 another minor correction
    [interface-alt.sch]
2013-07-17 PCB: Arduino shield headers locked in correct place. A bunch of other components roughly placed in board area.
    [freakduino.brd]
2013-07-17 PCB: Corrections to SMA footprint and a new 3D modle for it, too.
    [freakduino.brd]
2013-07-17 Added SMA connector datasheet.
2013-07-17 JST S2B-XH-A socket 3D package added and footprint corrected to 2.5mm pitch instead of previously assumed 2.54mm.
    [freakduino.brd, freakduino.sch]
2013-07-17 BOM corrected link for power jack J2. Corrected footprint pads and hole sizes from datasheet. KiCAD supplied ones were too small , again! Got to watch out for that. CHECK EVERYTHING.
    [freakduino.brd]
2013-07-18 Electrolytic capacitors C9,C15 footprint corrections and new 3D package to match. Wiki image added for project home page.
2013-07-18 Slide switch footprint and 3D package added. Document files added.
    [freakduino.brd]
2013-07-18 Balun chosen -- different to original Freakduino -- as 0805 part from Johanson Technology (Ex. element14). The pin connection layout is also different.
    PCB footprint and 3D package for balun added.
    Balun data sheet added.
    [freakduino.brd, freakduino.sch, interface-alt.sch, misc.sch, power.sch, radio.sch, usb.sch]
2013-07-18 LED 3D pacakges added.
    [freakduino.brd]
2013-07-18 CHANGING to -ALT files form this point onwards ...
    Due to a number of changes from the original Freakduino design, I'm now
    continuing my design in the freakduino-alt project, leaving a copy of the
    original work in the files without -alt.
    The single shre/ folder (freakduino.lib, etc) will contain components,
    and 3D modules for both versions.
    [freakduino-alt.brd, freakduino-alt.sch, interface.sch, misc.sch, power.sch, radio-alt.sch, usb.sch]
2013-07-18 Re-worked power supply boost circuit around an availabel part. Footprint and 3D package added for same.
    Fixed multiple DRC errors with default KiCAD parts (saved in local
    library.)
    Routed power boost circuit, paying attention to maximum GND/VSS
    shielding.
    Set up fills for 50ohm (approx.) traces around radio chip and rest of
    board, both sides.
    Updated BOM to reflect latest component changes.
    [freakduino-alt.brd, freakduino-alt.sch, freakduino-bom.xls, interface-alt.sch, misc.sch, power-alt.sch, radio-alt.sch, usb.sch]
2013-07-18 PCB routing commence in ernest.
    [freakduino-alt.brd]
2013-07-19 Routing complete. DRC passes. Everything _seems_ OK.
    Added Arduino reference design image to docs.
    [freakduino-alt.brd, freakduino-alt.sch, interface-alt.sch, misc.sch, power-alt.sch, radio-alt.sch, usb.sch]
2013-07-19 Added Arduino reference design image (for real this time). Added a couple of eye candy images of the just-done-routing KiCAD Freakduino. Yay \o/
2013-07-19 Issues with thermal relief on under side resolved (KiCAD bugs/quirks?).
    Production files produced in production-alt/ for initial Gerber inspection.
    [freakduino-alt.brd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]
2013-07-19 QFN32 3D package added.
    [freakduino-alt.brd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]
2013-07-19 MILESTONE MARKER - first completed PCB completed.
    Ammended BOM file(s) to refernce the substutute parts chossen.
    [freakduino-bom.xls]
2013-07-19 MILESTONE MARKER - First (really?) complete PCB.
    See Wiki Milestones page for details.
    Added Arduino connector silk text and Google Code site reference to silk layers.
    Moved some vias to get them clear of the text (even though we will be tenting
    them.)
    [freakduino-alt.brd]
2013-07-19 PCB: More silk work, adding switch and brand labels, etc.
    [freakduino-alt.brd]
2013-07-20 Via drill and copper size changes. (Now all metric, though most component drills are imperial. Hmmm. Let the PCB fab figure that one out!)
    Main issue was making sure that all main power feeds use larger vias,
    while allowing signal vias to be smaller, for space considerations.
    Also re-worked the 'paranoia' shilding around the DC-DC converter,
    to accomdate the larger VSS vias. {shrug}
    [freakduino-alt.brd]
2013-07-20 Re-worked DC-DC converter 'paranoia shilding' again. This time to make the VSS pin-3 trace shorter.
    [freakduino-alt.brd]
2013-07-20 Per last commit, only I actually hit SAVE before committing, this time. :/
    [freakduino-alt.brd]
2013-07-20 RF balun VSS trace was on wrong side of PCB. Corrected.
    [freakduino-alt.brd]
2013-07-20 Yet more improvements to DC-DC converter layout.
    [freakduino-alt.brd]
2013-07-20 Minimum track width increased from 0.150mm to 0.200mm, globally.
    [freakduino-alt.brd]
2013-07-20 Components obstructing PWM 9/10 silk text moved.
    LED D1 (Arduino D13) moved to be iactually next to I/O pin 13.
    [freakduino-alt.brd]
2013-07-20 Silk revision text's updated to read 'r55' (this commit).
    [freakduino-alt.brd]
2013-07-21 MILSTONE: r56
    Final(?) canges "finally" made? :P
    [freakduino-alt.brd]
2013-07-21 More finising touches. Will it ever end? :P Filled in some ground plain gaps on top layer. Helps save the environment, by gasing off less copper. :P
    [freakduino-alt.brd]
2013-07-22 Numberous errors around AVSS versus DVSS circuit separation fixed.
    An error in the schematic concerning net RESET_N found.
    Complete re-work of RF section, to correct impedance and ground system.
    And there I was, thinking the board was ready for production! It always
    pays to give it a few days for bugs to craw out of the woodwork. ;-)
    [freakduino-alt.brd, freakduino-alt.sch, interface-alt.sch, misc.sch, power-alt.sch, radio-alt.sch, usb.sch]
2013-07-22 Added thermal relief for main VSS ground planes, top and bottom.
    [freakduino-alt.brd]
2013-07-22 And yet more serious errors found. Gosh.
    [freakduino-alt.brd]
2013-07-22 Added doc file
    [freakduino-alt.brd]
2013-07-22 More silk text work.
    [freakduino-alt.brd]
2013-07-22 Impedance lowering, V-BUS (and some top-to-bottom layer ground plane links.)
    [freakduino-alt.brd]
2013-07-22 Thermal relief and via size corrections.
    [freakduino-alt.brd]
2013-07-22 Yet more silk work.
    [freakduino-alt.brd]
2013-07-22 Impedance lowering, VCC_IN.
    [freakduino-alt.brd]
2013-07-22 Misc VSS change.
    [freakduino-alt.brd]
2013-07-22 Impedance lowering (VBAT) and some minor copper savings.
    [freakduino-alt.brd]
2013-07-22 Added a couple of document files.
2013-07-23 PCB misc tidying and some more silk text.
    [freakduino-alt.brd]
2013-07-23 PCB: Tidied up component reference text locations.
    Consolidated 3D package files.
    [freakduino-alt.brd]
2013-07-23 PCB fabrication candidate v1.0.
    [freakduino-alt.brd, freakduino-alt.sch]
2013-07-23 Corrected R13 reference text location.
    Generated -alt v1.0 production files. (Checked all OK in GerbV.)
    [freakduino-alt-B_Cu.gbl, freakduino-alt-B_Mask.gbs, freakduino-alt-B_SilkS.gbo, freakduino-alt-Edge_Cuts.gbr, freakduino-alt-F_Cu.gtl, freakduino-alt-F_Mask.gts, freakduino-alt-F_SilkS.gto, freakduino-alt.drl]
2013-07-23 Fabrication Ready v1.0.
    Archived FROZEN.
    [freakduino-alt.brd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]
2013-07-23 Board silk revision number corrected (v1.0 frozen r100.)
    [freakduino-alt.brd]
2013-07-23 Forgot to regenerate production files for last commit.
    Correct silk text revision number (for real this time) v1.0 r101 FROZEN.
    [freakduino-alt.brd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]
2013-07-23 Restored missing 3D package files for 3x2, 3x1 and 2x1 pin arrays.
2013-07-23 BOM updated as result of actual parts order and availability.
    NOTE: Enough parts to build just 2 of these boards has cost more than
    USD$150, including the PCBs. So don't bother building unless, like
    me, you want the educational experience. Just buy completed units
    from Akiba at freaklabs.org.
    [freakduino-bom.xls]
2013-07-23 Misc BOM update.
    SMA 3D package now has white inner and spiralled threads, sort of. (I was bored.)
    [freakduino-bom.xls]
2013-07-27 Errors in RF section of r101 corrected. The PCBs ordered at r101 are now tea coasters. {sigh}
    The new v1.0 "first" production release is now r116.
    [freakduino-alt.brd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]
2013-07-27 Re-achiving r116 production frozen files.
    [freakduino-alt.brd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]
2013-07-28 I messed up with C10, again. Connected it to digital ground, instead of analog ground. Corrected in this commit.
    Given that C10 is so iphysically close to C12, I will justleave C10
    off the production prototype board(s) already ordered.
    [freakduino-alt.brd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]
2013-08-12 + Changes to BOM (wrong pin order on previously chosen 3.3V regulator) + Part documents added.
    [freakduino-alt.brd, freakduino-bom.xls]
2013-08-12 "Pin 1" indication on silk layer added for ISP connector.
    [freakduino-alt.brd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]
2013-08-12 BOM update: Corrections to components, post-r116 ...
    + C2 was too large. Should be 6.3mm diameter version
    + L2 was correct value and current rating but core too small (saturating)
    NOTE: PCB not yet changed to accomodate new L2.
    Previous commit BOM change ...
    + Regulator U2 was wrong pin order. Needs to be IGO, not GOI.
    [freakduino-bom.xls]
2013-08-12 Increased L2 size again (doubled). This roughly matches the unit I used in testing to get good results. So, playing it safe.
    The PCB land pattern is 6.0 x 5.5mm, overall. There is room beside
    the IDC socket, where theoriginal Freakduino through-hole parts
    were.
    [freakduino-bom.xls]
2013-08-13 PCB updated for new (larger) L2. Also corrected reverse slide switch function.
    [freakduino-alt.brd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]
2013-08-13 Changed my mind re L2. The datasheet for the TPS61222 says that the Taiyo Yuden NR3015 series inductors have been used successfully.
    Element14 don't stock a 4.7uH in that size, so I've gone just one size up, to
    NR4018. This is 4x4mm overall package footprint, which is 2x2mm smaller than my
    previous decision.
    Also added 3D pacake for this part.
    Regenerated drill and Gerber files. Bumped version to v1.1.
    This should be the next production version, unless I find problems with the RF
    section, once I'm able to test it.
    [freakduino-alt.brd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]
2013-08-13 Changed all 220ohm LED resistors to 1Kohm. This is how I actually built the first r116 test board. The LEDs are still too bright for my liking, actually. This way, we may also save a little battery p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
    [freakduino-alt.brd, freakduino-alt.sch, freakduino-bom.xls, interface-alt.sch, misc.sch, power-alt.sch, radio-alt.sch, usb.sch]
2013-08-15 Various minor improvements, mostly concerning ground plane vias.
    [freakduino-alt.brd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]
2013-08-15 Couple more super-minor via placement improvements. Perhaps I should go mow the lawn? :-P
    [freakduino-alt.brd]
2013-08-15 Moved C10 slightly.
    [freakduino-alt.brd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]
2013-08-15 Yet more ground plane via improvements.
    [freakduino-alt.brd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]
2013-08-16 Numberous more problems with the circuit design and PCB layout errors found and corrected as a result of debugging and making the RF section work, today, finally.
    There remains and issue with the SPI port disable jumper not working as it should -- I think. I got around this by fluke, when I realised that holding down the reset button (somehow) enables my AVR ISP mkII to program the AVR chip, despite the suspected SPI bus conflict between the ISP and level shofter chip. (Not that any of that makes sense to me right now. But that's what seemed to be the case, at the time. I'll sort it later.)
    [freakduino-alt.brd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]
2013-08-16 Final tidy-ups for (hopefully) final PCB fabrication. Bumped version to v1.2.
    [freakduino-alt.brd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]
2013-08-17 Updated BOM for corrected BALUN part. (PCB changes not yet addressed.)
    [freakduino-bom.xls]
2013-08-17 Re-worked the RF transmission line circuitry.
    I'm frustrated. I've searched high and low for line impedance calculators and I
    keep getting the same answers I did the first time around. But my tracks are
    much more narrow and more closely spaced than Akiba's -- and my RF section has
    massive attenuation. Evidently, his version works well and mine quite simply
    does not. Thus, I've now had no choice but to blindly copy his design, as best
    I can and hope for the best.
    This is NOT how I like to do things. I want to understand what I am doing and
    why. So, I will keep trying to find the answers, of course. Meanwhile, I want
    this particular project DONE.
    [freakduino-alt.brd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]
2013-08-17 OMG LOL. I have the wrong gender SMA connector -- so my antenna was not connecting!
    I made the connecton work, by inserting a piece of wire (gender-bender :-P) and
    what do you know? Full signal strength! Good grief.
    \o/
    Yay
    Now everything makes sense! LOL Reverting to the r176 design.
    I'll locate the correct SMA jack part and update the BOM later.
    [freakduino-alt.brd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]
2013-08-18 Corrections to BOM file. Improvements to PCB ground plane.
    [freakduino-alt.brd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]
2013-08-18 PCB: Minor. Just removed the DNI (do not install / optional) components from the 3D view.
    [freakduino-alt.brd]
2013-09-28 Revision r189 frozen for production.
    Frozen production folders moved to /tags folder.
    [freakduino-alt.brd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]
2013-10-30 LED datasheet added. Parts layout files added.
    [freakduino-alt.brd, freakduino-bom.xls]
2013-10-30 Fixing Apple Numbers file format change (1)
    [freakduino-alt.brd]
2014-02-14 Created a "radio-only" breakout board for just the AT86RF231 chip, etc. This is to enable testing of of the Chibi stack on different CPUs.
    [freakduino-alt.brd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]
2014-02-14 + Added board dimensions + Added radio breakout board Gerber ZIP.
    [radio-only.brd]
2014-03-03 Corrections to C8/12 decoupling caps. Should be 0u01, not 0u1 (not critical).
    [freakduino-alt.brd, freakduino-alt.sch, freakduino.brd, freakduino.sch, interface-alt.sch, interface.sch, misc.sch, power-alt.sch]
2014-03-03 Changed the radio test board a) to lie on its side and b) to include slp_tr (oops).
    [radio-only.brd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]
2014-03-03 Added outer board dimensions.
    [radio-only.brd]
2014-03-14 BOM correction: 2.4GHz blanu shoould be the 0805 part, not the 0603 version.
    [freakduino-bom.xls]
2014-03-14 A number of corrections to copper pour net names, fixing glaring errors in the last (2nd) production version of this little board. *sigh*
    These errors were introduced through some random means. None of the copper pour
    areas were edited during the creating of this radio-onlyboard, compared to the
    original full, KiCAD-Freakduino. For htese and similar problems from using
    KiCAD, which are costly, I have made the reluctant decision to switch to
    Diptrace, a commerical product, though generous in its free license
    capabilities.
    [radio-only.brd]
2014-03-27 Changed L1 to a 0402 part, because the 0603's are getting hard to find. (Acutally, I've been using the 0402 part since the beginning. It just, barely reaches between the pads. Kept forgetting to chan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
    [freakduino-alt.brd, freakduino-alt.sch, misc.sch, radio-only.brd, radio-only.sch, usb.sch]
